vroom57/thermal-probe-alerter/hw-2.0-pico-python-MAXI/README.md

# TempAlerter Type K x4 - MAXI - ALPHA

> [!NOTE]
> Code and hardware are in **Alpha**. hw-2.0 runs on a breadboard but is on
> hold and will probably not go further.

hw-2.0 breadboard prototype: Pico W, buzzer, 13 LEDs, and four MAX6675 boards labeled TK1RIn to TK4LOut, with the DS18B20 low-temp probes and the 20x4 LCD showing live readings

## Where does hw-2.0 stand?

As I was building this and thinking about hardware enclosures, I realized that
this was getting overly complex. Never a good sign.

8 temp probes, buzzers, and needing to expand the LEDs, which meant using
either an SN74HC595N to multiplex the LEDs with limited GPIO ports, or
something like the MCP23017 I2C IO expansion board to give me more LEDs. So
then I went off on a side project of replacing the LEDs with a Pico Display
Pack 2.8" LCD display, so I could really make this an amazing project. Part of
that project was using C instead of Python. Python is handy, but it's
interpreted on a Pico. C is compiled: you drop a binary on, and it boots and
runs like lightning. And with Claude Code in an Ubuntu VM, it's so easy to get
things done.

So all that said, hw-2.0 is probably dead. The code does run on the breadboard
prototype shown above. It's here in case anyone wants to see it or take it on.

I'm heading to hw-3.0 ([`../hw-3.0-pico-c-MINI/`](../hw-3.0-pico-c-MINI/)),
which uncomplicates everything: a single Pico, possibly a display, and a single
high-temp and/or low-temp probe in a small box. Picos are so cheap that if I
want 4 probes, I'll just use 4 mini boxes. I'm thinking the outer cases can
also clip together like Lego, so you can just connect each mini together with
another mini and expand it that way.
 The limitations are an IP address for each monitor and a
USB cable for power. But hw-3.0 is going to be written in C, and be fast,
reliable, and super cheap.

## Current state of hw-2.0

Hardware v2.0: four Type K probes, DS18B20 low-temp probes, a buzzer, 13 LEDs,
and a 20x4 LCD display. It builds on hardware v1.0 (see
[`../hw-1.0-pico-python/`](../hw-1.0-pico-python/)) but is a separate product
with its own code.

## What it does

TempAlerter is a four-channel high-temperature monitor and alarm built on a
Raspberry Pi Pico W running MicroPython.

- Reads four Type K thermocouples through MAX6675 boards on a shared bus
  (TK1 Right In, TK2 Left In, TK3 Right Out, TK4 Left Out), in degrees F,
  with a per-probe calibration offset.
- Reads DS18B20 low-temp probes on a 1-Wire bus (TempLow1-4), with per-probe
  calibration offsets.
- Sorts each Type K reading into one of four ranges (under / low / med /
  high). TK1 drives the right-side LEDs and TK2 the left-side LEDs (Blue,
  Green, Yellow, Red). TK3 drives the top-right Yellow and Red LEDs. The top-left Red and Yellow
  LEDs are wired but not used by the code yet.
- Tracks the maximum temperature for each Type K probe over a rolling window
  (`MAX_TEMP_WINDOW`, default 20 minutes), and holds the peak of any
  over-temperature event for the same window.
- Sounds the buzzer for TK1 and TK2: a short beep on Green to Yellow, a
  shorter beep on Yellow to Green, and three beeps on every update while in
  the "high" range.
- Shows outer probes (actual/max), inner probes (actual/max), the low-temp
  probes, and WiFi signal strength with the IP address on the 20x4 LCD.
- Connects to WiFi at startup. The top green LED stays lit (with a quick
  flicker each update) while WiFi is up.
- Sends an email alert through Gmail (SMTP over SSL) when any Type K probe
  reaches the "high" range, if `EMAIL_ENABLED` is True. While it stays high,
  the alert repeats at most once every `resend_email_interval` seconds
  (default 120).
- Optional: a watchdog timer (`WATCHDOG_ENABLED`) and a WiFi keepalive ping
  to the gateway (`KEEPALIVE_ENABLED`) to help with mesh-network roaming.

## Temperature probes

Figures below are from the chip datasheets.

| | DS18B20 (low-temp) | Type K + MAX6675 board (high-temp) |
| :--- | :--- | :--- |
| **Range** | −55 to +125 °C (−67 to +257 °F) | 0 to +1024 °C (32 to ~1875 °F) |
| **Accuracy** | ±0.5 °C (±0.9 °F) from −10 to +85 °C, ±2 °C outside that | Roughly ±2–3 °C |
| **Resolution** | Up to 0.0625 °C | 0.25 °C |
| **Reads below freezing?** | Yes | **No** |

- **Fridges and freezers:** use the DS18B20. A freezer at about −18 °C
  (0 °F) is well within its range.
- **Ovens and diesel heater exhaust:** use the Type K. Ovens reach about
  260 °C (500 °F), past the DS18B20's 125 °C limit.
- The MAX6675 board cannot read below 0 °C (32 °F), even though a Type K
  thermocouple can. For Type K below freezing, a MAX31855 board covers about
  −200 to +1350 °C.

> [!IMPORTANT]
> This is an **uncalibrated** hobby unit. The real range and accuracy depend
> on the quality of the probes and boards you buy. Cheap waterproof DS18B20
> probes often have cable jackets rated well below 125 °C, and many Type K
> probes are only rated to about 400–600 °C. Check each part's listing, and
> compare readings against a known-good thermometer before trusting them.
> `main.py` has per-probe offsets (`temp_calibration_*`) to correct each
> reading.

## Setup notes

- WiFi, email, and SMTP settings go in `config.py` (use a Gmail app
  password). Keep real values out of anything you share.
- `main.py` ships with email **off** (`EMAIL_ENABLED = False`) and with
  room-temperature **test** thresholds (`under_val`, `low_val`, `high_val`
  near the top of the file). Hold a probe between your fingers to reach the
  "high" range and trigger the red LED and buzzer. Once setup is verified,
  set your own operating values and turn email on.
- The right thresholds depend on what you are measuring and when you want to
  be alerted. The commented-out values in `main.py` are examples only. All
  temperatures are in degrees Fahrenheit.
- The LCD code expects four DS18B20 probes to be connected.
- Upload all files in `Python_Code_Place_On_Pico/` to the root of the Pico W
  (e.g. with Thonny). `main.py` runs automatically at power-up.
- `Test_Code/` holds standalone test scripts (LED chase and buzzer, DS18B20
  probes, WiFi ping, system check). They are not needed on the Pico.

Wiring and pin assignments are documented in `CLAUDE.md`,
`schematic-hw2.0.jpg`, and `parts_list.txt`.

## License

Copyright (C) 2026 Virgil Mehalek

TempAlerter is free software, licensed under the GNU General Public License
v3.0 or later. See the [LICENSE](LICENSE) file for the full text.

## Credits

These third-party libraries in `Python_Code_Place_On_Pico/` are used under the
MIT License. Full license notices are in
[THIRD_PARTY_LICENSES.txt](THIRD_PARTY_LICENSES.txt).

| File | Author | Source |
| :--- | :--- | :--- |
| `lcd_api.py` | Dave Hylands | https://github.com/dhylands/python_lcd |
| `lcd_pico_i2c.py` | Tyler Peppy (based on Dave Hylands' python_lcd) | https://github.com/T-622/RPI-PICO-I2C-LCD |
| `max6675.py` | Ivan Sevcik (modified for a shared bus) | https://github.com/BetaRavener/micropython-hw-lib |
| `umail.py` | Shawwwn | https://github.com/shawwwn/uMail |
| `wifi_ping.py` | Wataru KUNINO (adapted) | https://github.com/bokunimowakaru/ping |

## Disclaimer

This is a personal hobby project, provided "as is" without warranty of any
kind. Use it at your own risk.

It is NOT designed, tested, or certified for life-safety, fire-protection,
medical, or other critical uses, and must not be relied on to protect people,
animals, or property. Temperature readings may be inaccurate, and alerts
(LEDs, buzzer, display, and email) can be delayed or fail entirely because of
sensor, wiring, WiFi, power, or software faults.

Always use properly certified safety devices (smoke and CO detectors, thermal
cutoffs, etc.) for anything that matters. The author accepts no liability for
any damage, injury, or loss resulting from use of this code or hardware
design.
