vroom57/thermal-probe-alerter/hw-1.0-pico-python/Pictures/20261015_190804000_iOS.png

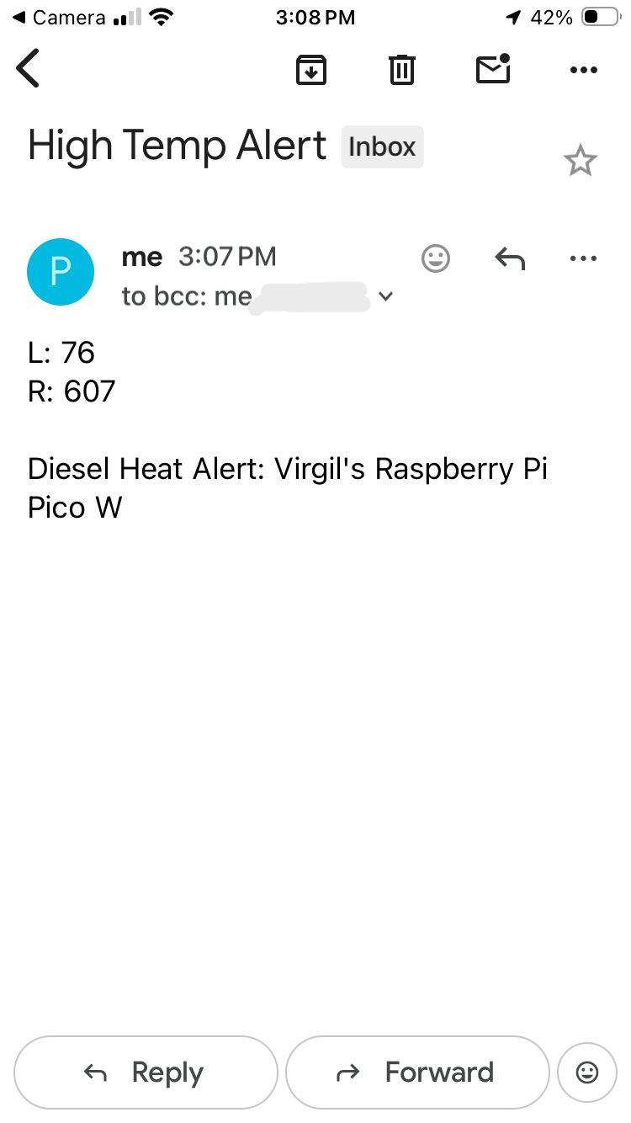
hw-1.0-pico-python/Pictures/20261015_190804000_iOS.png
