vroom57/thermal-probe-alerter/hw-1.0-pico-python/Schematic_MarkedUp_v1.0.jpg

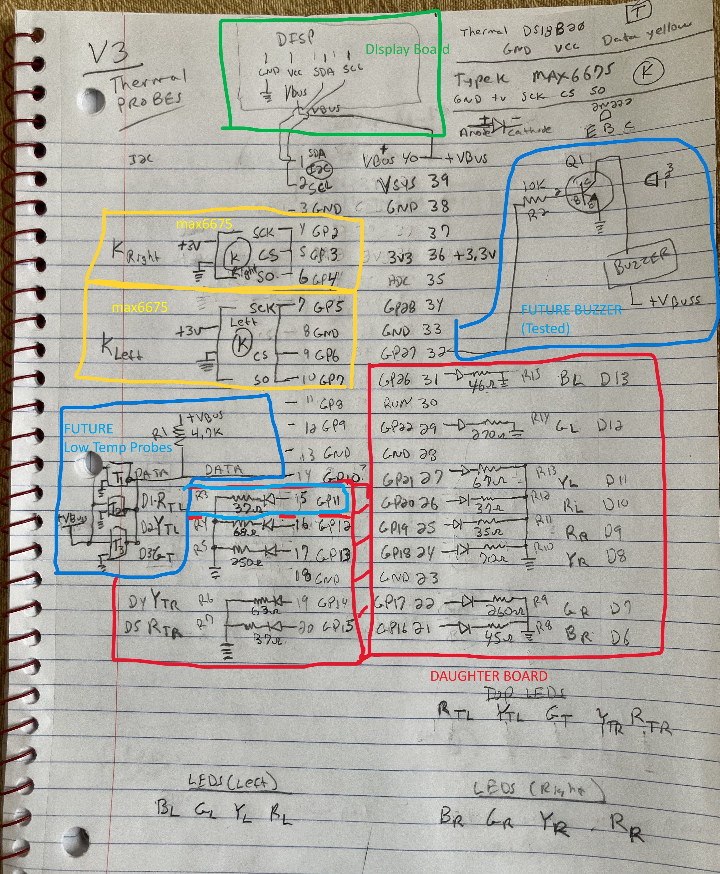
hw-1.0-pico-python/Schematic_MarkedUp_v1.0.jpg
