vroom57/thermal-probe-alerter/hw-2.0-pico-python-MAXI/Pictures/20261019_193809101_iOS.jpg

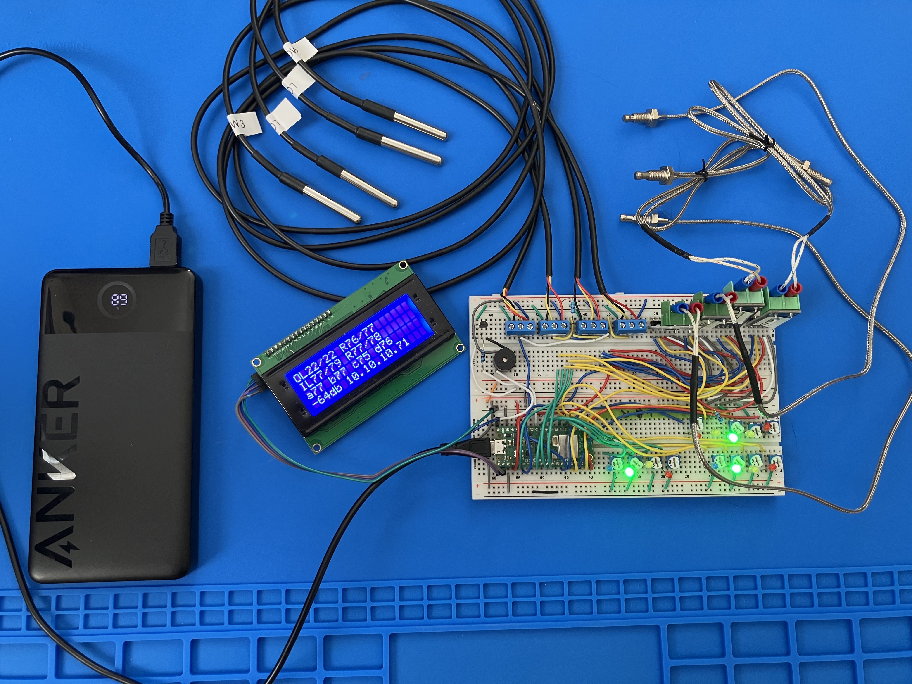
hw-2.0-pico-python-MAXI/Pictures/20261019_193809101_iOS.jpg
