vroom57/thermal-probe-alerter/hw-2.0-pico-python-MAXI/Pictures/20261019_193858260_iOS.jpg

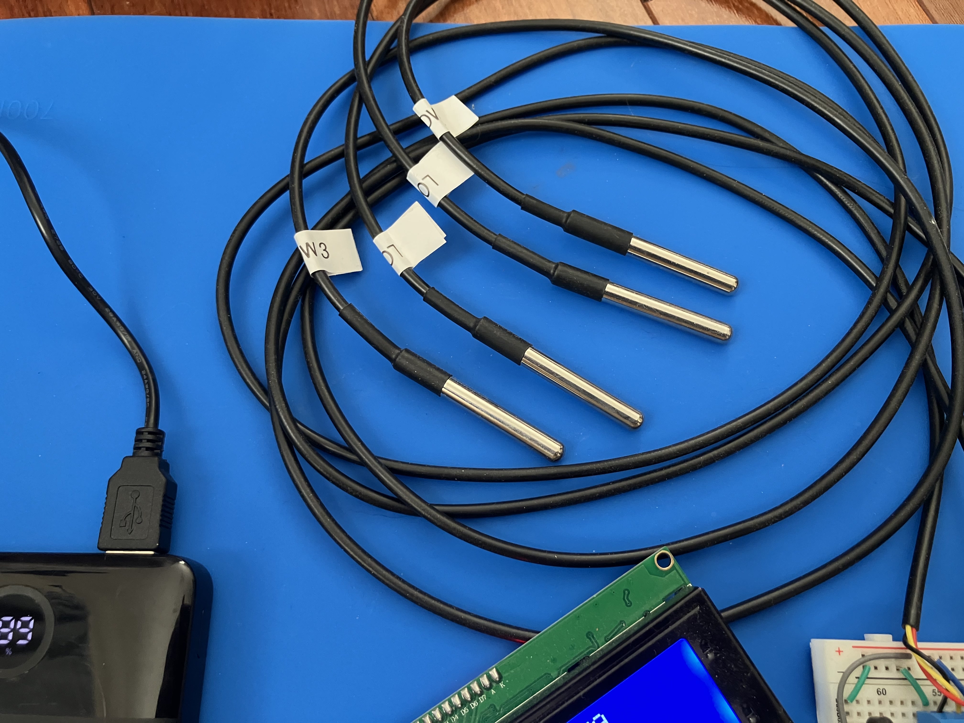
hw-2.0-pico-python-MAXI/Pictures/20261019_193858260_iOS.jpg
