vroom57/thermal-probe-alerter/hw-1.0-pico-python/parts_list.txt

PARTS LIST - Hardware v1.0
(Resistor values are approximate, hand-tuned to each LED for relative brightness)

QTY 1: Pico W - Gen 1 Raspberry Pi RP2040 Chip, WiFi Wireless Connectivity, Pico WH
QTY 1: Display - LCD1602 1602 LCD Module Blue Screen HD44780 equivalent LCD controller (I2C)
QTY 2: MAX6675 Type K thermocouple board
QTY 2: Type K probes
QTY 2: Type K probe connectors
QTY 3: Red LED
QTY 3: Yellow LED
QTY 3: Green LED
QTY 3: Blue LED
QTY 3: R7, R11, R12 - 37ohm Red LED
QTY 3: R6, R10, R13 - 68ohm Yellow LED
QTY 3: R5, R9, R14 - 260ohm Green LED
QTY 3: R4, R8, R15 - 46ohm Blue LED
QTY 1: 3D printed lower box
QTY 1: 3D printed box lid
Miscellaneous hardware (wire, screws, etc.)

FUTURE (not in hardware v1.0):
QTY 1: Red LED (D1, top left, GP11)
QTY 1: R3 - 37ohm Red LED (D1)
QTY 1: R1 4.7k - DS18B20 temp probe pull-up
QTY 3: DS18B20 thermal probes
QTY 1: R2 10k - buzzer, to base of 2N2222 transistor
QTY 1: 2N2222 NPN transistor
QTY 1: Buzzer - 5V Active Buzzer Electronic Alarm CYT1036, Current: <25mA, Input Voltage: 4-8VDC
