vroom57/thermal-probe-alerter/hw-1.0-pico-python/AI_Table_Description.xlsx

Pico1 | Pico W - Gen 1 | Raspberry Pi RP2040 Chip, WiFi Wireless Connectivity,Pico WH
Disp1 | Display 1 | Display - LCD1602 1602 LCD Module Blue Screen HD44780 equivalent LCD controller
Q1 | 2N2222 | Transistor to Drive Buzzer
BUZ | CYT1036 | Buzzer - 5V Active Buzzer Electronic Alarm CYT1036 Current: <25mA Input Voltage: 4-8VDC
TempKLeft | Type K Left | Type max6675 Type K board
TempKRight | Type K Right | Type max6675 Type K board
TempLow1 | Low Temp T1 | Type DS18B20 Thermal Probes
TempLow2 | Low Temp T2 | Type DS18B20 Thermal Probes
TempLow3 | Low Temp T3 | Type DS18B20 Thermal Probes
R1 | 4.7k | Resistor for TempLow1, 2, 3
R2 | 10k | Resistor for Base of 2n2222 Transistor for Buzzer
R3, R7, R11, R12 | 37ohm | Red LED Resistor
R4, R6, R10, R13 | 68ohm | Yellow LED Resistor
R5, R9, R14 | 260ohm | Green LED Resistor
R8, R15 | 46ohm | Blue LED Resistor
D1 | Red LED RTL | Red Top Left
D2 | Yellow LED YTL | Yellow Top Left
D3 | Green LED GT | GreenTop Middle
D4 | Yellow LED YTR | Yellow Top Right
D5 | Red LED RTR | Red Top Right
D6 | Blue LED BR | Blue Right (bottom)
D7 | Green LED GR | Gree Right (bottom)
D8 | Yellow LED YR | Yellow Right (bottom)
D9 | Red LED RR | Red Right (bottom)
D10 | Red LED RL | Red Left (bottom)
D11 | Yellow LED YL | Yellow Left (bottom)
D12 | Green LED GL | Green Left (bottom)
D13 | Blue LED BL | Blue Left (bottom)
Pico1 Pin 1 SDA (I2C) to Disp1 SDA Pin
Pico1 Pin 2 SCL (I2C) to Disp1 SCL pin
Disp1 Pin GND to Pico1 Pin 3 GND
Disp1 Pin Vcc to Pico1 Pin 40 Vbus
Pico1 Pin4 GP2 to TempKLeft Pin SCK
Pico1 Pin5 GP3 to TempKLeft Pin CS
Pico1 Pin6 GP4 to TempKLeft Pin SO
Pico1 Pin7 GP5 to TempKRight Pin SCK
Pico1 Pin9 GP6 to TempKRight Pin CS
Pico1 Pin10 GP7 to TempKRight Pin SO
Pico1 Pin14 GP10 to TempLow1 Data
Pico1 Pin14 GP10 to TempLow2 Data
Pico1 Pin14 GP10 to TempLow3 Data
TempLow1 Vdd to Pico Pin 40 Vbus
TempLow2 Vdd to Pico Pin 40 Vbus
TempLow3 Vdd to Pico Pin 40 Vbus
TempLow1 GND to Pico Pin 3 GND
TempLow2 GND to Pico Pin 3 GND
TempLow3 GND to Pico Pin 3 GND
Pico1 Pin 15 GP11 to D1 to R3 to GND
Pico1 Pin 16 GP12 to D2 to R4 to GND
Pico1 Pin 17 GP13 to D3 to R5 to GND
Pico1 Pin 19 GP14 to D4 to R6 to GND
Pico1 Pin 20 GP15 to D5 to R7 to GND
Pico1 Pin 21 GP16 to D6 to R8 to GND
Pico1 Pin 22 GP17 to D7 to R9 to GND
Pico1 Pin 24 GP18 to D8 to R10 to GND
Pico1 Pin 25 GP18 to D9 to R11 to GND
Pico1 Pin 26 GP20 to D10 to R11 to GND
Pico1 Pin 27 GP21 to D11 to R13 to GND
Pico1 Pin 29 GP22 to D12 to R14 to GND
Pico1 Pin 31 GP26 to D13 to R15 to GND
Pico1 Pin32 GP27 to R2 to Q1 Base
Q1 Emitter to GND
Q1 Collector to BUZ
BUZ to Vbus
