vroom57/thermal-probe-alerter/hw-1.0-pico-python/3D_PrinterFiles/Temperature_Probe-2x-Alerter-Bottom v9.stl

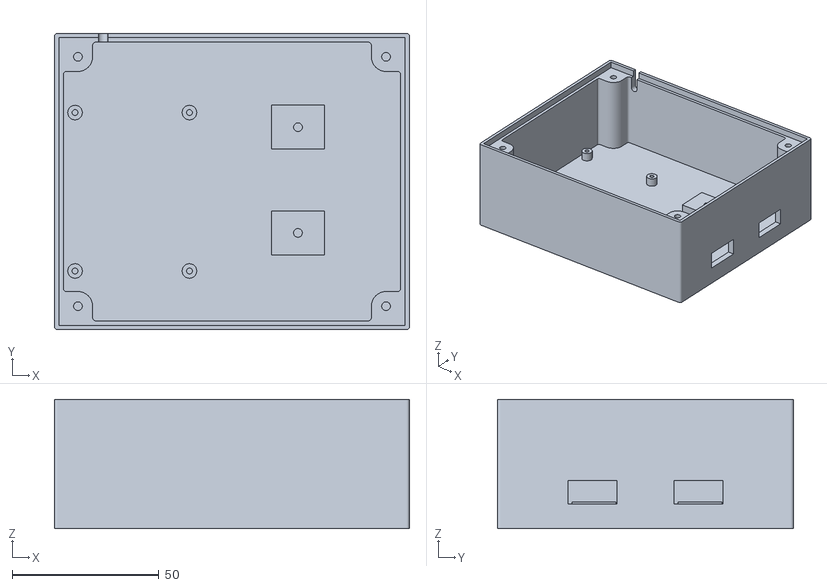
[picture p25: CAD file, 2026-10-16]
hw-1.0-pico-python/3D_PrinterFiles/Temperature_Probe-2x-Alerter-Bottom v9.stl
121.0 x 101.0 x 44.0
