vroom57/thermal-probe-alerter/hw-1.0-pico-python/3D_PrinterFiles/Temperature_Probe-2x-Alerter-LID v7.stl

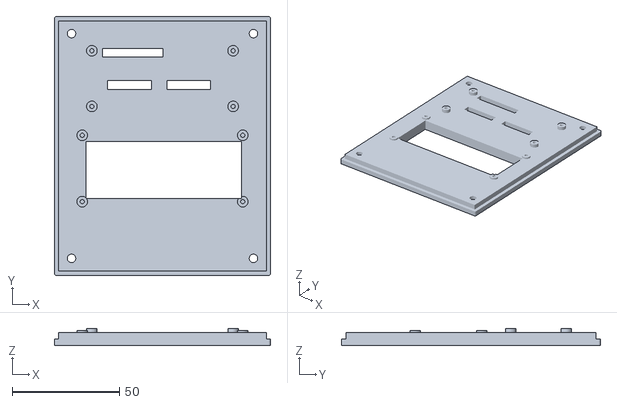
[picture p26: CAD file, 2026-10-16]
hw-1.0-pico-python/3D_PrinterFiles/Temperature_Probe-2x-Alerter-LID v7.stl
101.0 x 121.0 x 8.00
