vroom57/thermal-probe-alerter/(list of files, cad)

Other CAD files:
hw-1.0-pico-python/3D_PrinterFiles/Temperature_Probe-2x-Alerter-Bottom v9.f3d
hw-1.0-pico-python/3D_PrinterFiles/Temperature_Probe-2x-Alerter-LID v7.f3d
