vroom57/thermal-probe-alerter/hw-1.0-pico-python/3D_PrinterFiles/README.txt

This are the 3d print files for the Thermal Project. See notes below.

.f3d Fustion 360 Files
.stl Bamboo printer ready (Bamboo X1C)

Notes:
Printed first one in PLA on Engineering Hot plate

Display hole and registration of standoffs could use a little work.

Same with the USB-A cable to micro USB on the Pico - needs to be shifted so the cable fits easier.

Screws are small standard self tapping screws (100deg?), could use inserts if you want more strength.
