vroom57/thermal-probe-alerter/(commit log)

2026-10-16 Add hw-1.0 Pico W MicroPython project and repo structure
    - hw-1.0-pico-python: TempAlerter for hardware v1.0 (two Type K probes
    via MAX6675, 12 LEDs, 16x2 I2C LCD, Gmail alerts), with docs,
    schematics, parts list, 3D printer files, photos (GPS removed),
    and third-party MIT license notices
    - hw-2.0-pico-c: placeholder for the future Pico C SDK build
    - Root README describing both projects
    [AI_Table_Description.xlsx, Temperature_Probe-2x-Alerter-Bottom v9.f3d, Temperature_Probe-2x-Alerter-Bottom v9.stl, Temperature_Probe-2x-Alerter-LID v7.f3d, Temperature_Probe-2x-Alerter-LID v7.stl]
2026-10-17 Document temperature thresholds as test defaults in Fahrenheit
    Explain that main.py intentionally ships with room-temperature test
    thresholds so a new build can be verified by holding a probe, that
    operating values depend on the application, and that all values are
    in degrees Fahrenheit.
2026-10-17 Add TODO for moving settings to config.py; fix CLAUDE.md typo
    TODO.txt records the planned point release: an EMAIL_ENABLED switch in
    config.py (already_sent cannot disable email because the loop re-arms
    it) and moving the remaining hard-coded settings out of main.py.
2026-10-17 Rename Python_Code to Python_Code_Place_On_Pico
    Makes it obvious which folder gets copied to the Pico W. Updates all
    references in the READMEs and third-party license notices.
2026-10-19 hw-2.0: set up project structure and licensing from hw-1.0 template
    - Add working hw-2.0 MicroPython code from the Pico (4x MAX6675 on a
    shared bus, DS18B20 probes, buzzer, 20x4 LCD)
    - Add GPL headers to project files and MIT headers to third-party
    libraries; note max6675.py shared-bus modification; add wifi_ping.py
    (MIT, Wataru KUNINO) to THIRD_PARTY_LICENSES.txt
    - Add SMTP settings to config.py placeholder (read by main.py)
    - Move test scripts to Test_Code/
    - Add README, CLAUDE.md pin map, TODO, parts list, hw-2.0 schematic,
    and photos (GPS metadata stripped)
    - Update root README for hw-2.0
    [TEST_led_chase.py, config.py, connect_to_internet.py, lcd_api.py, lcd_pico_i2c.py, low_temp_probe_test.py, main.py, max6675.py]
2026-10-19 hw-2.0: add home page photo, rename to MAXI - ALPHA
    - Add Pictures/HW2.0_SW2.0_Alpha.jpg to the hw-2.0 README
    - Change placeholder name from MAXI - BETA to MAXI - ALPHA
    (still a breadboard prototype)
    - Drop the "pick README photos" TODO item
2026-10-19 Put hw-2.0 on hold and add hw-3.0-pico-c-MINI
    - hw-2.0 README: add status note explaining why hw-2.0 is on hold and
    the move to hw-3.0; fix formatting and typos
    - hw-2.0 TODO and CLAUDE.md: mark as on hold at Alpha; add GPIO limit item
    - Add hw-3.0-pico-c-MINI with planning README (single probe, buzzer,
    one unit per fridge/freezer/oven, Pico C SDK) and LICENSE
    - Root README: general project description, hw-2.0 status, hw-3.0 row
2026-10-19 Show hw-2.0 photo on home pages
    - Root README: replace HomePage_02.png with the hw-2.0 prototype photo
    (HomePage_02.jpg) and update its alt text and caption
    - hw-2.0 README: move photo to the top, under the Alpha note
2026-10-19 Root README: remove hw-1.0 getting-started section
    The same setup notes are in hw-1.0-pico-python/README.md.
2026-10-19 Root README: add temperature range to project description
2026-10-19 hw-3.0 README: add probe temperature ranges and calibration note
2026-10-19 hw-2.0 README: add probe temperature table, probe guidance, and calibration note
2026-10-19 hw-1.0 README: add Type K probe temperature table and calibration note
