vroom57/thermal-probe-alerter/(notices)

Notices in the files:
hw-2.0-pico-python-MAXI/Python_Code_Place_On_Pico/main.py:
under the terms of the GNU General Public License as published by the Free
