vroom57/thermal-probe-alerter/hw-1.0-pico-python/Pictures/20261015_190935454_iOS.jpg

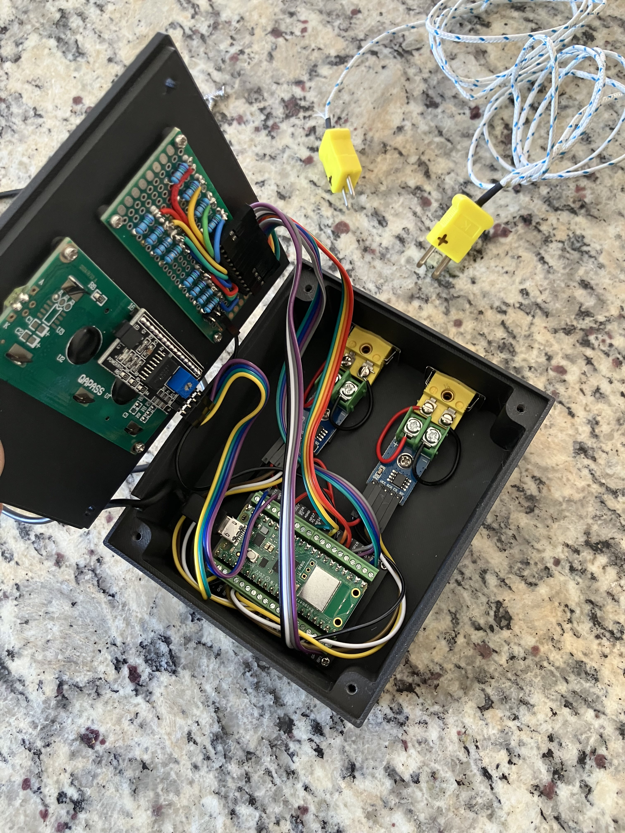
hw-1.0-pico-python/Pictures/20261015_190935454_iOS.jpg
