vroom57/thermal-probe-alerter/hw-1.0-pico-python/Schematic.jpg

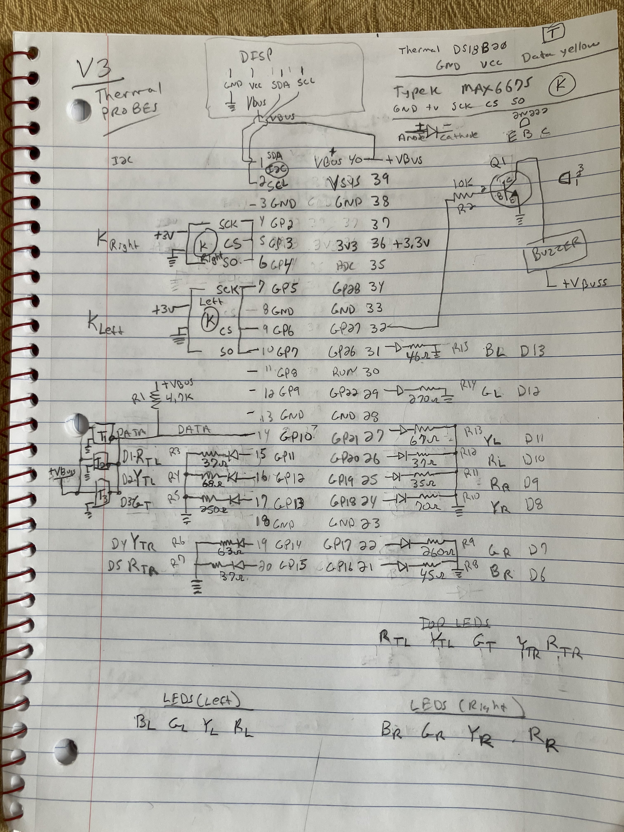
hw-1.0-pico-python/Schematic.jpg
