vroom57/thermal-probe-alerter/hw-2.0-pico-python-MAXI/schematic-hw2.0.jpg

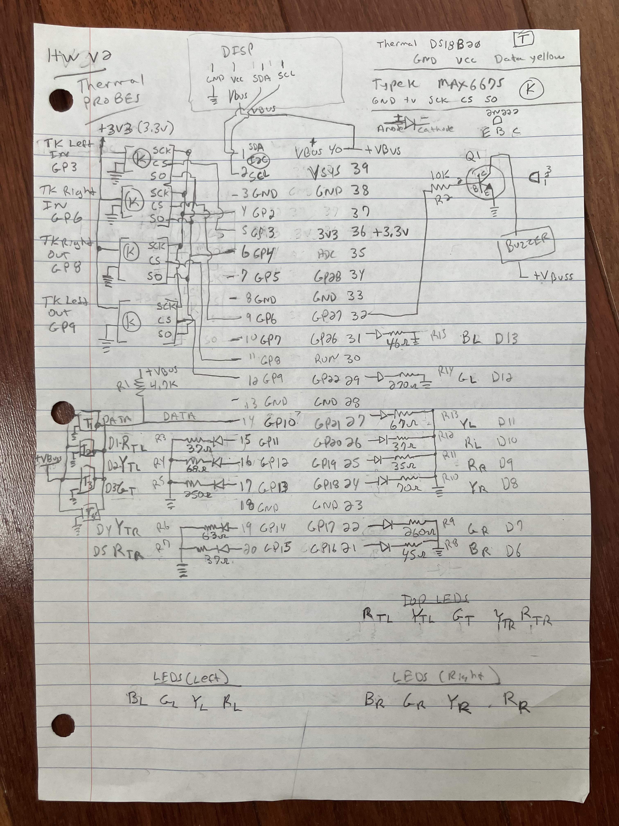
hw-2.0-pico-python-MAXI/schematic-hw2.0.jpg
